ZetaGG/trampa-trips/3MF/ligero/assembly.3mf

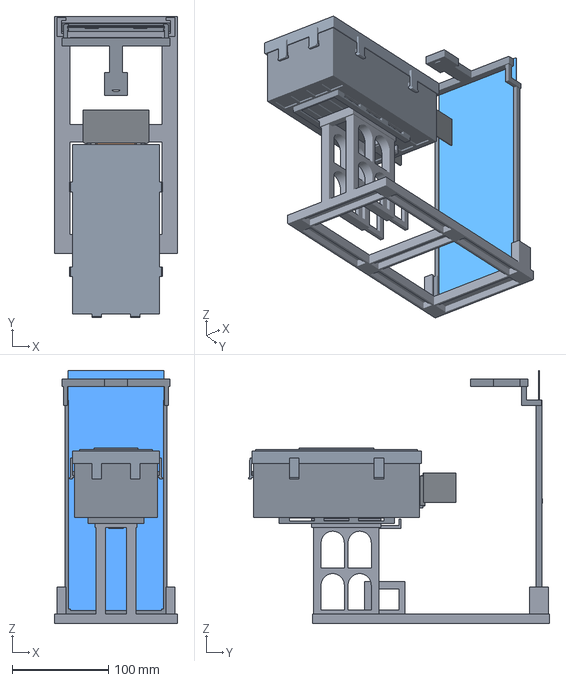
[picture p1: CAD file, 2026-11-03]
3MF/ligero/assembly.3mf
128.0 x 312.4 x 263.0 mm
