ZetaGG/trampa-trips/3MF/ligero/tapa_carcasa.3mf

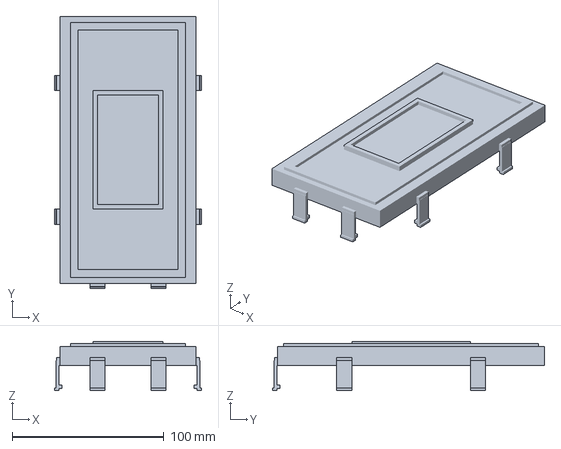
[picture p2: CAD file, 2026-11-03]
3MF/ligero/tapa_carcasa.3mf
96.8 x 179.3 x 32.5 mm
