ZetaGG/trampa-trips/Ediciones propias/CajaTrips (2).3mf

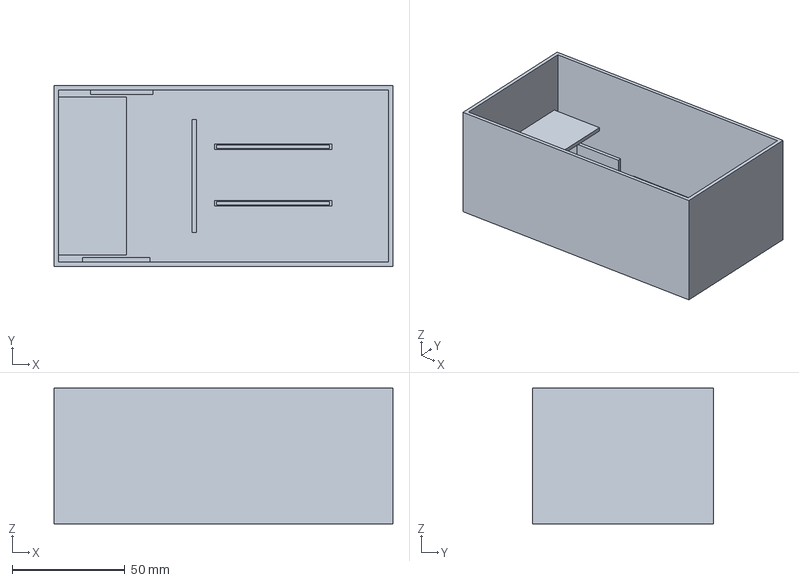
[picture p3: CAD file, 2026-11-03]
Ediciones propias/CajaTrips (2).3mf
150.0 x 80.0 x 60.0 mm
