ZetaGG/trampa-trips/3MF/ligero/parasol_capucha.3mf

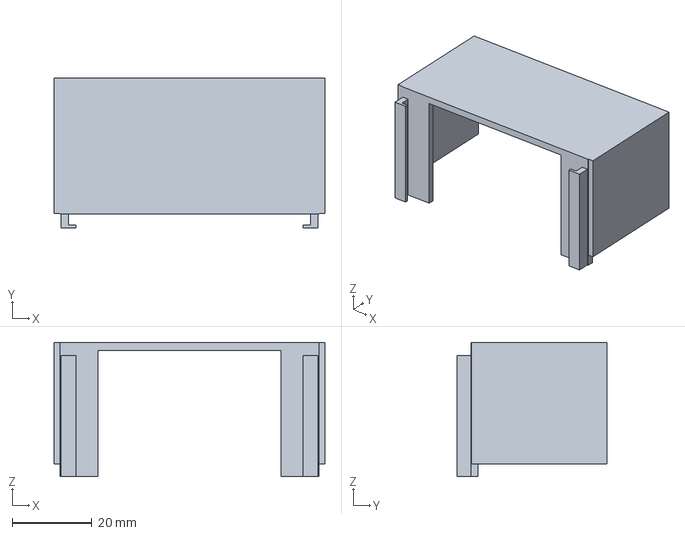
[picture p4: CAD file, 2026-11-03]
3MF/ligero/parasol_capucha.3mf
68.0 x 37.7 x 33.6 mm
