ZetaGG/trampa-trips/3MF/ligero/chasis_bandeja.3mf

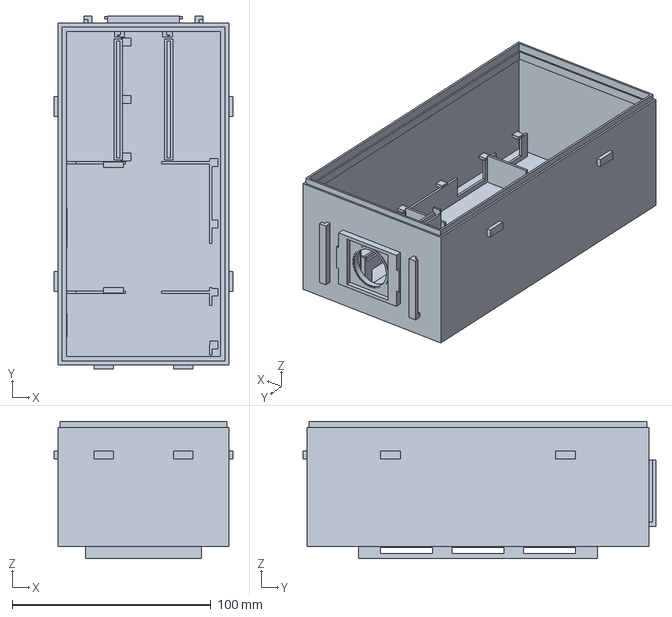
[picture p5: CAD file, 2026-11-03]
3MF/ligero/chasis_bandeja.3mf
90.0 x 177.5 x 69.0 mm
