ZetaGG/trampa-trips/3MF/ligero/soporte_base.3mf

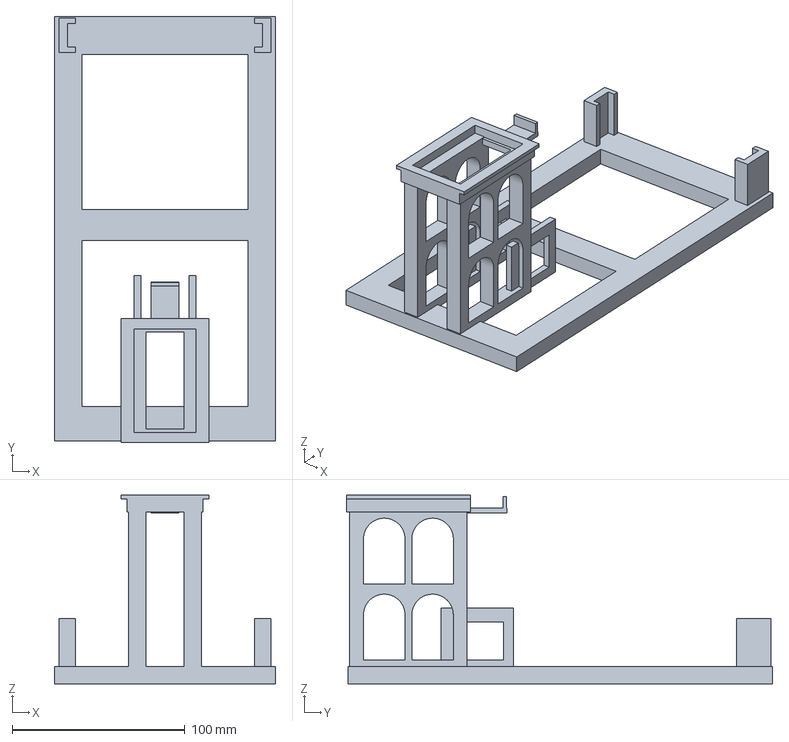
[picture p6: CAD file, 2026-11-03]
3MF/ligero/soporte_base.3mf
128.0 x 247.0 x 109.4 mm
