ZetaGG/trampa-trips/3MF/ligero/bisel_ventana.3mf

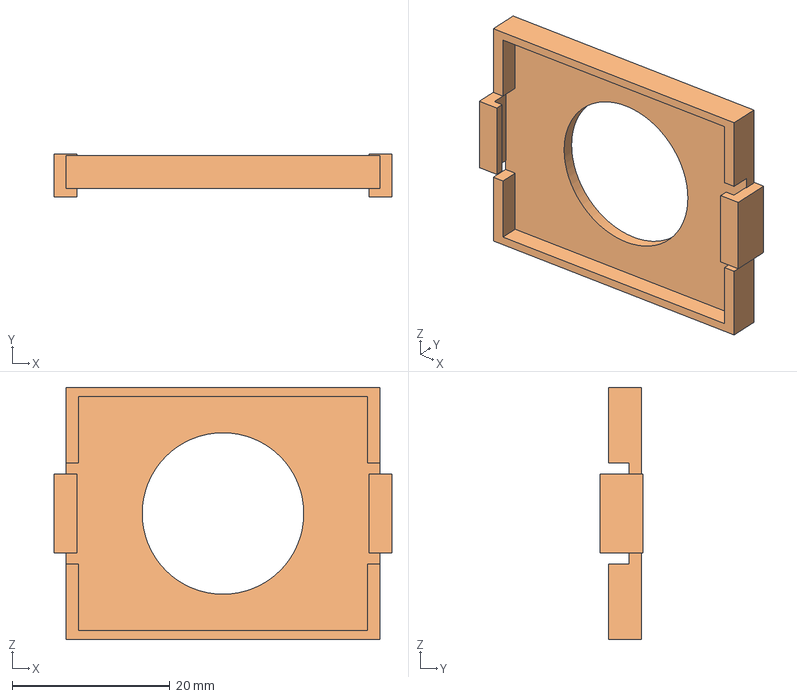
[picture p7: CAD file, 2026-11-03]
3MF/ligero/bisel_ventana.3mf
42.9 x 5.40 x 32.0 mm
