ZetaGG/trampa-trips/3MF/ligero/marco_tarjeta.3mf

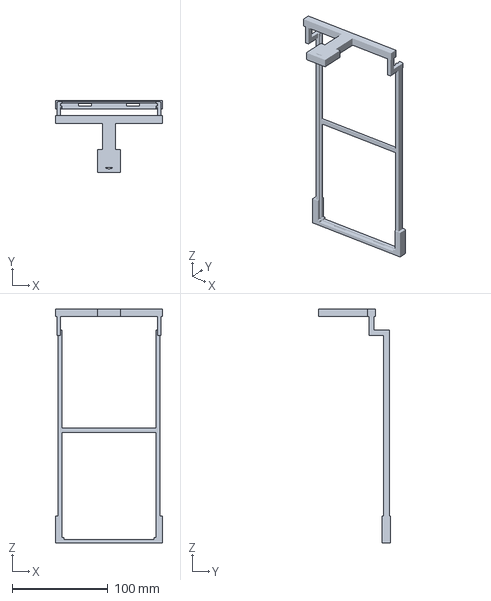
[picture p8: CAD file, 2026-11-03]
3MF/ligero/marco_tarjeta.3mf
112.0 x 75.5 x 244.0 mm
