ZetaGG/trampa-trips/3MF/ligero/ventana_pc.3mf

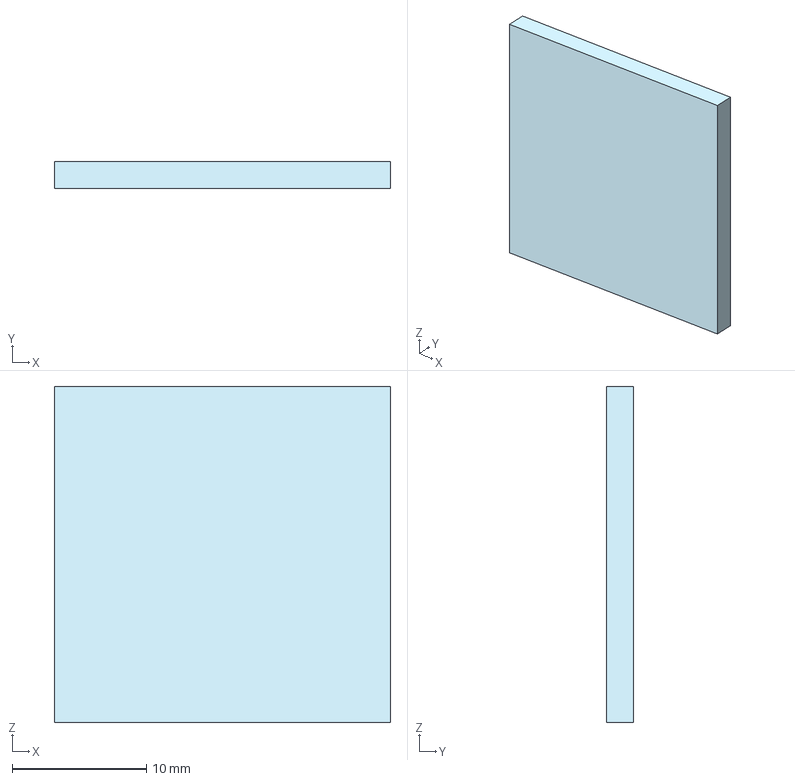
[picture p9: CAD file, 2026-11-03]
3MF/ligero/ventana_pc.3mf
25.0 x 2.00 x 25.0 mm
