ZetaGG/trampa-trips/3MF/ligero/tarjeta_azul.3mf

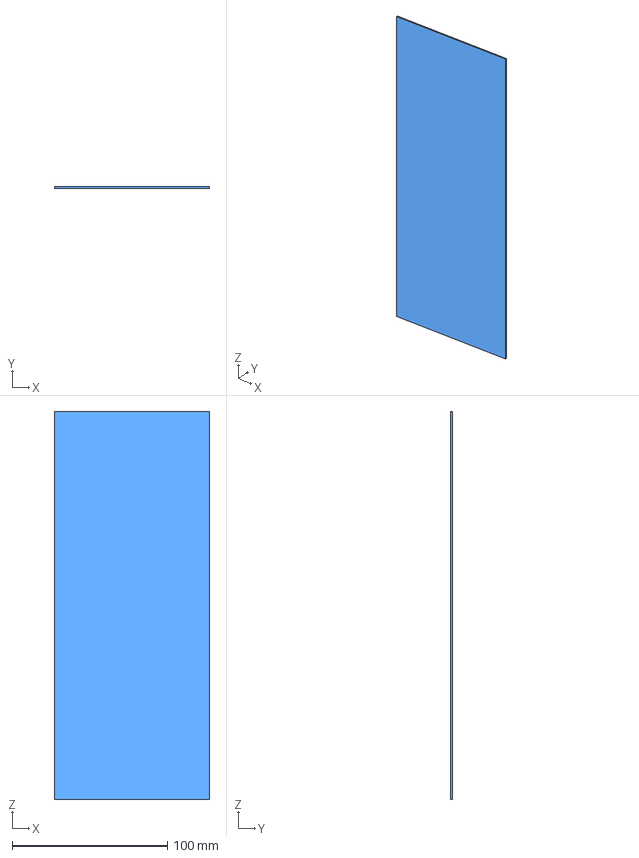
[picture p10: CAD file, 2026-11-03]
3MF/ligero/tarjeta_azul.3mf
100.0 x 1.00 x 250.0 mm
