ZetaGG/trampa-trips/3MF/tapa_carcasa.3mf

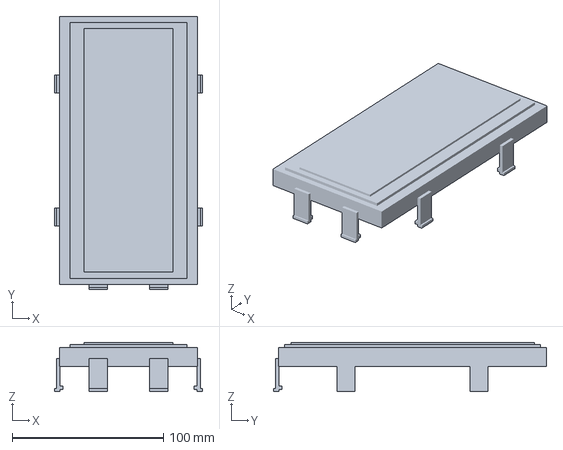
[picture p11: CAD file, 2026-11-03, an earlier design]
3MF/tapa_carcasa.3mf
97.8 x 180.4 x 32.5 mm
