ZetaGG/trampa-trips/3MF/bisel_ventana.3mf

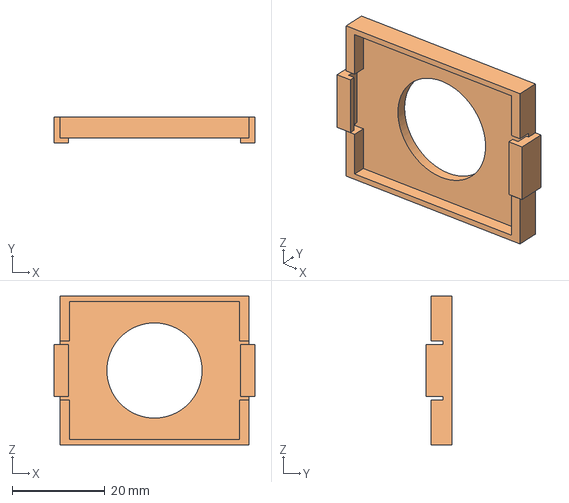
[picture p12: CAD file, 2026-11-03, an earlier design]
3MF/bisel_ventana.3mf
43.3 x 5.65 x 32.0 mm
