ZetaGG/trampa-trips/3MF/parasol_capucha.3mf

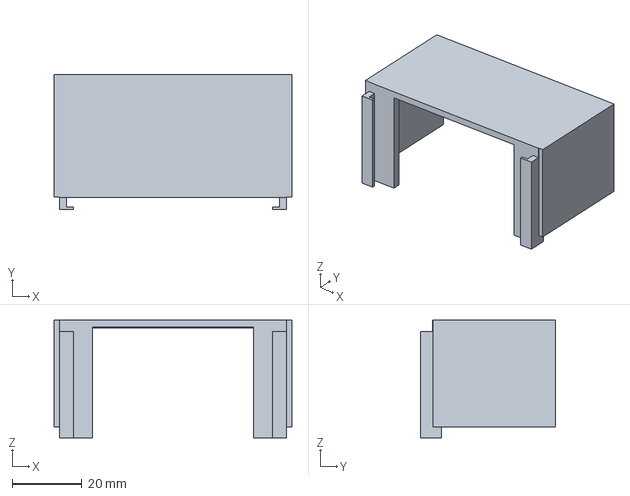
[picture p13: CAD file, 2026-11-03, an earlier design]
3MF/parasol_capucha.3mf
68.0 x 38.7 x 33.6 mm
