ZetaGG/trampa-trips/3MF/soporte_base.3mf

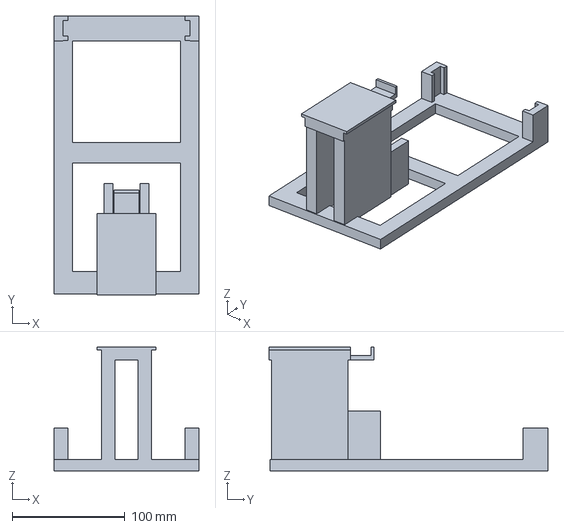
[picture p14: CAD file, 2026-11-03, an earlier design]
3MF/soporte_base.3mf
128.0 x 247.0 x 109.6 mm
