ZetaGG/trampa-trips/3MF/marco_tarjeta.3mf

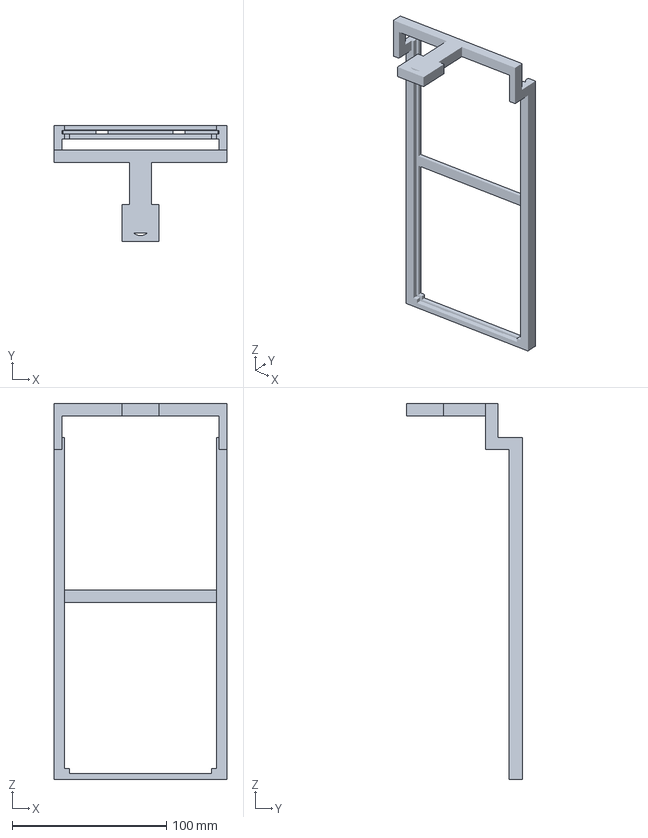
[picture p15: CAD file, 2026-11-03, an earlier design]
3MF/marco_tarjeta.3mf
112.0 x 75.5 x 244.0 mm
