ZetaGG/trampa-trips/(list of files, cad)

Other CAD files:
3MF/assembly.3mf
3MF/chasis_bandeja.3mf
STL/bisel_ventana.stl
STL/chasis_bandeja.stl
STL/ligero/bisel_ventana.stl
STL/ligero/chasis_bandeja.stl
STL/ligero/marco_tarjeta.stl
STL/ligero/parasol_capucha.stl
STL/ligero/soporte_base.stl
STL/ligero/tapa_carcasa.stl
STL/ligero/tarjeta_azul.stl
STL/ligero/ventana_pc.stl
STL/marco_tarjeta.stl
STL/parasol_capucha.stl
STL/soporte_base.stl
STL/tapa_carcasa.stl
