ZetaGG/trampa-trips/(commit log)

2026-11-03 Trampa de Trips Inteligente: diseño 3D modular sin tornillos
    - 6 piezas impresas en PETG (chasis, tapa, bisel, parasol, marco, base)
    - Sellado laberinto + labio flexible PETG (Opción B, sin TPU)
    - Batería 12V 4000mAh extraíble + buck LM2596 12V->3.3V
    - ESP32-S3 + cámara OV5640 + microSD + LED de estado
    - Verificación geométrica/topológica y de interferencias (0 colisiones)
    [assembly.3mf, bisel_ventana.3mf, bisel_ventana.stl, chasis_bandeja.3mf, chasis_bandeja.stl, marco_tarjeta.3mf, marco_tarjeta.stl, parasol_capucha.3mf]
2026-11-03 Revisión de ruteo de cables: túnel bajo la ESP, canaleta lateral y piso con costillas
    - Chasis 86x172x60: túnel de cables bajo la ESP con retenedores, pasos centrales
    en los tabiques, canaleta lateral derecha y ranuras de salida del conector DC.
    - Batería y buck elevados sobre costillas de piso (trinchera de cables por debajo).
    - Sin interruptor, sin LED, sin sílice (la electrónica va sellada y la batería se extrae).
    - Verificación: 8/8 piezas sólido único/válido/sonoro, 190 pares, 0 colisiones.
    - Se agrega el boceto de referencia del usuario en Ediciones propias/.
    [CajaTrips (2).3mf, assembly.3mf, bisel_ventana.3mf, bisel_ventana.stl, chasis_bandeja.3mf, chasis_bandeja.stl, parasol_capucha.3mf, parasol_capucha.stl]
2026-11-03 Versión ligera para imprimir: -46% de material con las mismas medidas
    Copia independiente en src/ligero/ que conserva medidas externas, datums,
    clips, laberinto y distancia óptica, adelgazando muros y vaciando macizos:
    - Chasis: muros 1.8 mm, piso 1.6 mm con ranuras (puentes cortos), rieles de
    pines tipo puente de 3 apoyos, tabiques y canaleta de 1.2 mm.
    - Tapa: techo como cáscara de 2 mm; escalones macizos -> borde elevado +
    placa central (misma silueta); clips, laberinto y labio PETG idénticos.
    - Base: travesaños y patines ahuecados por debajo, columnas en celosía con
    ventanas en arco autoportantes; misma huella 128x247 mm.
    - Marco: canales en C de 6.5x6.0 mm (arco y gancho a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
    [assembly.3mf, bisel_ventana.3mf, bisel_ventana.stl, chasis_bandeja.3mf, chasis_bandeja.stl, marco_tarjeta.3mf, marco_tarjeta.stl, parasol_capucha.3mf]
